Javid-Xi/IoT-Security-Alarm-System/README.md

# IoT-Security-Alarm-System

Project in [2018](https://github.com/Javid-Xi/IoT-Security-Alarm-System)  
Control Chip: STM32F103C8T6

****
For more details, please see [my blog post](https://javid.cn/lelink/)
****

## Development Environment

### 1.SOLIDWORKS 2018
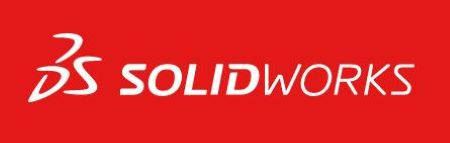
[picture p1: Photo/software/solidworks.jpg]
(https://www.solidworks.com)


### 2.Keil uVision5
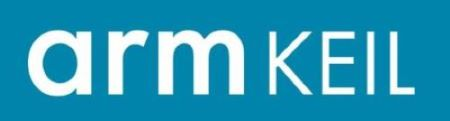
[picture p2: Photo/software/keil.jpg]
(http://www.keil.com)


### 3.Android Studio
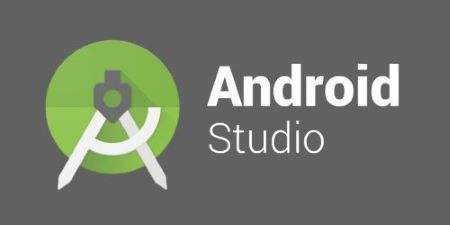
[picture p3: Photo/software/android-studio-logo.jpg]
(https://developer.android.com/studio)


### 4.STM32CubeMX
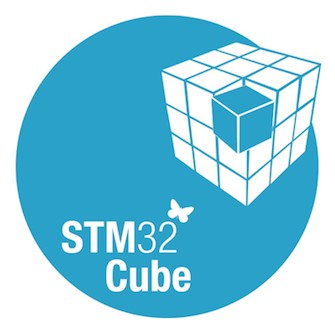
[picture p4: Photo/software/stm32cubemx.jpg]
(https://www.st.com/zh/development-tools/stm32cubemx.html)


## Cloud Platform

### 1.Gizwits(机智云)
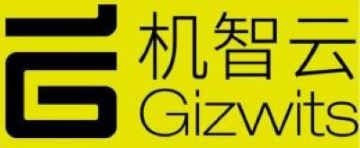
[picture p5: Photo/software/Gizwits.jpg]
(http://www.gizwits.com/)
   
(Click the picture to enter the official website of Gizwits)
