Javid-Xi/IoT-Security-Alarm-System/Model/README.md

## IoT-Security-Alarm-System

由于之前机械硬盘出现损坏，所以模型文件丢失了。现在只有当时出的渲染图了。

The model file was lost because the previous mechanical hard disk was damaged. 
Now only the Renderings is preserved.
