Javid-Xi/IoT-Security-Alarm-System/Model/baojing.jpg

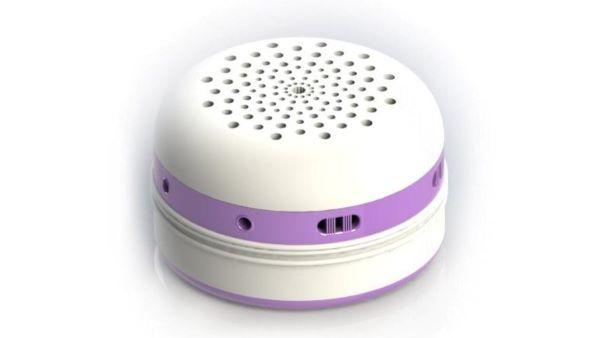
Model/baojing.jpg
