Javid-Xi/IoT-Security-Alarm-System/Model/menci.jpg

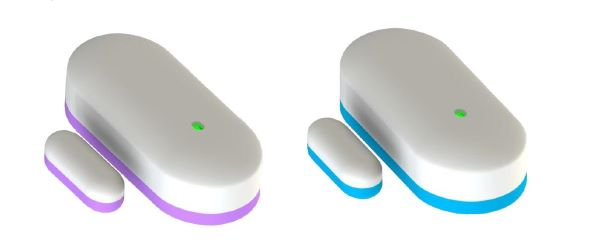
Model/menci.jpg
