Javid-Xi/IoT-Security-Alarm-System/Model/wangguan.jpg

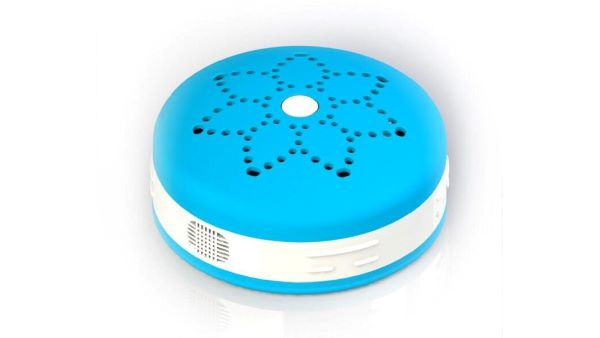
Model/wangguan.jpg
