Javid-Xi/IoT-Security-Alarm-System/Model/yanwu.jpg

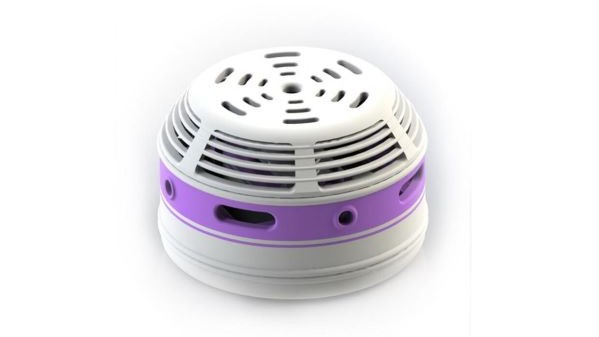
Model/yanwu.jpg
