Javid-Xi/IoT-Security-Alarm-System/Photo/Photo1.jpg

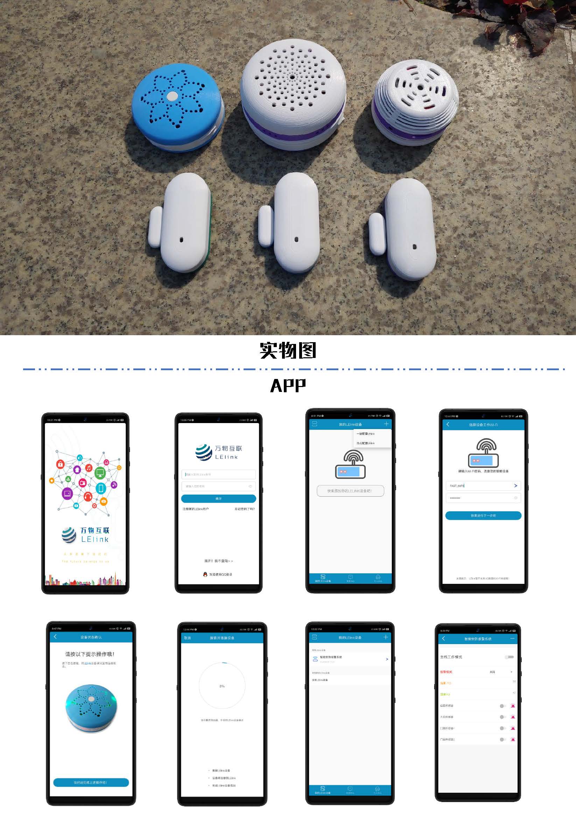
Photo/Photo1.jpg
