Javid-Xi/IoT-Security-Alarm-System/Photo/Photo2.jpg

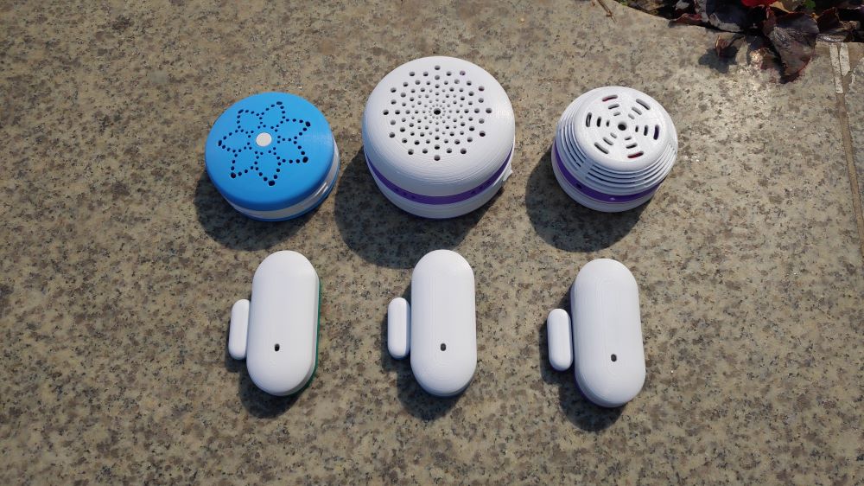
Photo/Photo2.jpg
