Javid-Xi/IoT-Security-Alarm-System/Photo/Photo4.jpg

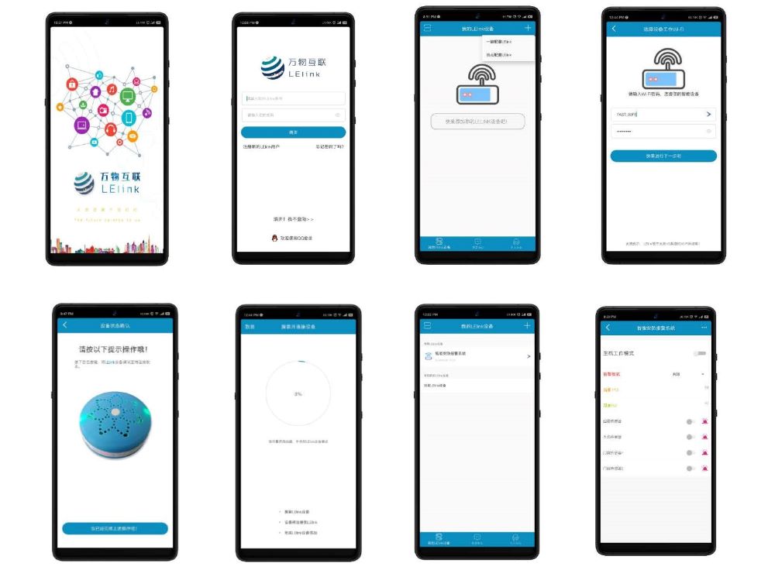
Photo/Photo4.jpg
