Javid-Xi/IoT-Security-Alarm-System/Photo/Photo-无线门磁.jpg

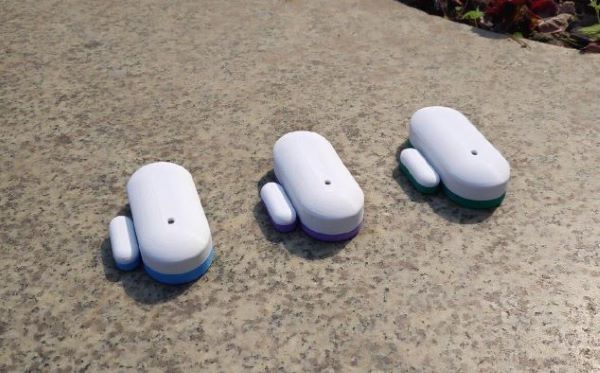
Photo/Photo-无线门磁.jpg
