Javid-Xi/IoT-Security-Alarm-System/Photo/Photo-气体监控模块.jpg

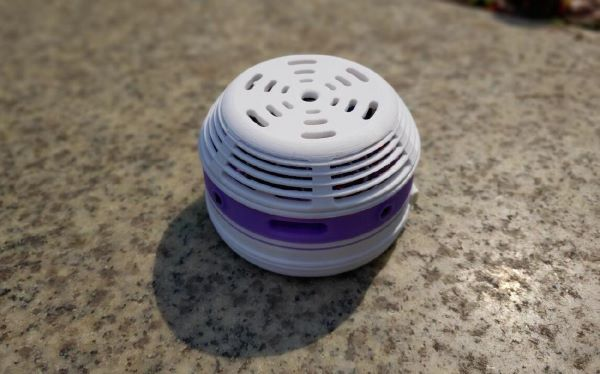
Photo/Photo-气体监控模块.jpg
