Javid-Xi/IoT-Security-Alarm-System/Photo/Photo-语音报警器.jpg

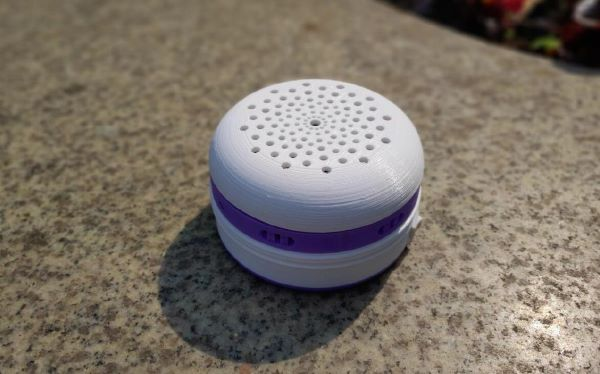
Photo/Photo-语音报警器.jpg
