Javid-Xi/IoT-Security-Alarm-System/Photo/software/freertos.jpg

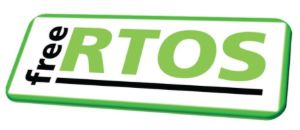
Photo/software/freertos.jpg
