Javid-Xi/IoT-Security-Alarm-System/Model/sldprt/S&F_Maincover.sldprt

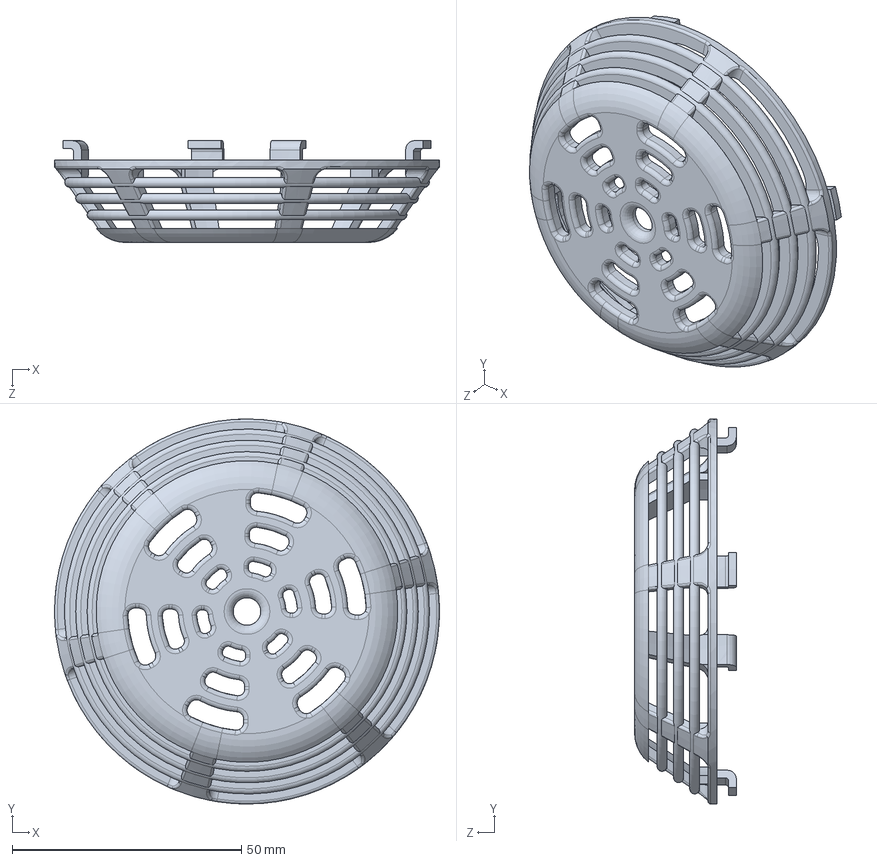
[picture p42: CAD file, 2020-02-01]
Model/sldprt/S&F_Maincover.sldprt
84.0 x 84.0 x 22.2 mm
