Javid-Xi/IoT-Security-Alarm-System/MCU_Program/MCU/Src/main.c

/**
  ******************************************************************************
  * File Name          : main.c
  * Description        : Main program body
  ******************************************************************************
  ** This notice applies to any and all portions of this file
  * that are not between comment pairs USER CODE BEGIN and
  * USER CODE END. Other portions of this file, whether
  * inserted by the user or by software development tools
  * are owned by their respective copyright owners.
  *
  * COPYRIGHT(c) 2019 STMicroelectronics
  *
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
  ******************************************************************************
  */
/* Includes ------------------------------------------------------------------*/
#include "main.h"
#include "stm32f1xx_hal.h"

/* USER CODE BEGIN Includes */
#include "hal_key.h"
#include "gizwits_product.h"
#include "common.h"
/* USER CODE END Includes */

TIM_HandleTypeDef htim2;

UART_HandleTypeDef huart1;
UART_HandleTypeDef huart2;
UART_HandleTypeDef huart3;

/* USER CODE BEGIN PV */
#define GPIO_KEY_NUM 2 ///< Defines the total number of key member
keyTypedef_t singleKey[GPIO_KEY_NUM]; ///< Defines a single key member array pointer
keysTypedef_t keys;
/* USER CODE END PV */

void SystemClock_Config(void);
static void MX_GPIO_Init(void);
static void MX_TIM2_Init(void);
static void MX_USART2_UART_Init(void);
static void MX_USART1_UART_Init(void);
static void MX_USART3_UART_Init(void);
static void MX_NVIC_Init(void);

/* USER CODE BEGIN PFP */

/* USER CODE END PFP */

/* USER CODE BEGIN 0 */
/**
* key1 short press handle
* @param none
* @return none
*/
void key1ShortPress(void)
{
    GIZWITS_LOG("KEY1 PRESS ,Production Mode\n");
    gizwitsSetMode(WIFI_PRODUCTION_TEST);
}

/**
* key1 long press handle
* @param none
* @return none
*/
void key1LongPress(void)
{
    GIZWITS_LOG("KEY1 PRESS LONG ,Wifi Reset\n");
    gizwitsSetMode(WIFI_RESET_MODE);

}

/**
* key2 short press handle
* @param none
* @return none
*/
void key2ShortPress(void)
{
    GIZWITS_LOG("KEY2 PRESS ,Soft AP mode\n");
#if !MODULE_TYPE
    gizwitsSetMode(WIFI_SOFTAP_MODE);
#endif
}

/**
* key2 long press handle
* @param none
* @return none
*/
void key2LongPress(void)
{
    //AirLink mode
    GIZWITS_LOG("KEY2 PRESS LONG ,AirLink mode\n");
#if !MODULE_TYPE
    gizwitsSetMode(WIFI_AIRLINK_MODE);
#endif
}

/**
* Key init function
* @param none
* @return none
*/
void keyInit(void)
{
    singleKey[0] = keyInitOne(NULL, KEY1_GPIO_Port, KEY1_Pin, key1ShortPress, key1LongPress);
    singleKey[1] = keyInitOne(NULL, KEY2_GPIO_Port, KEY2_Pin, key2ShortPress, key2LongPress);
    keys.singleKey = (keyTypedef_t *)&singleKey;
    keyParaInit(&keys);
}
/* USER CODE END 0 */

int main(void)
{

    /* MCU Configuration----------------------------------------------------------*/

    /* Reset of all peripherals, Initializes the Flash interface and the Systick. */
    HAL_Init();

    /* Configure the system clock */
    SystemClock_Config();

    /* Initialize all configured peripherals */
    MX_GPIO_Init();
    MX_TIM2_Init();
    MX_USART2_UART_Init();
    MX_USART1_UART_Init();
    MX_USART3_UART_Init();

    /* Initialize interrupts */
    MX_NVIC_Init();

    /* USER CODE BEGIN 2 */
    timerInit();
    uartInit();

    userInit();
    gizwitsInit();
    keyInit();
    GIZWITS_LOG("MCU Init Success \n");
    /* USER CODE END 2 */

    /* Infinite loop */
    /* USER CODE BEGIN WHILE */
    while (1)
    {
        /* USER CODE END WHILE */

        /* USER CODE BEGIN 3 */
//	HAL_UART_Transmit(&huart3,&Zigbee_data,1,10);
        userHandle();
        gizwitsHandle((dataPoint_t *)&currentDataPoint);
    }
    /* USER CODE END 3 */

}

/** System Clock Configuration
*/
void SystemClock_Config(void)
{

    RCC_OscInitTypeDef RCC_OscInitStruct;
    RCC_ClkInitTypeDef RCC_ClkInitStruct;

    /**Initializes the CPU, AHB and APB busses clocks
    */
    RCC_OscInitStruct.OscillatorType = RCC_OSCILLATORTYPE_HSE;
    RCC_OscInitStruct.HSEState = RCC_HSE_ON;
    RCC_OscInitStruct.HSEPredivValue = RCC_HSE_PREDIV_DIV1;
    RCC_OscInitStruct.HSIState = RCC_HSI_ON;
    RCC_OscInitStruct.PLL.PLLState = RCC_PLL_ON;
    RCC_OscInitStruct.PLL.PLLSource = RCC_PLLSOURCE_HSE;
    RCC_OscInitStruct.PLL.PLLMUL = RCC_PLL_MUL9;
    if (HAL_RCC_OscConfig(&RCC_OscInitStruct) != HAL_OK)
    {
        _Error_Handler(__FILE__, __LINE__);
    }

    /**Initializes the CPU, AHB and APB busses clocks
    */
    RCC_ClkInitStruct.ClockType = RCC_CLOCKTYPE_HCLK | RCC_CLOCKTYPE_SYSCLK
                                  | RCC_CLOCKTYPE_PCLK1 | RCC_CLOCKTYPE_PCLK2;
    RCC_ClkInitStruct.SYSCLKSource = RCC_SYSCLKSOURCE_PLLCLK;
    RCC_ClkInitStruct.AHBCLKDivider = RCC_SYSCLK_DIV1;
    RCC_ClkInitStruct.APB1CLKDivider = RCC_HCLK_DIV2;
    RCC_ClkInitStruct.APB2CLKDivider = RCC_HCLK_DIV1;

    if (HAL_RCC_ClockConfig(&RCC_ClkInitStruct, FLASH_LATENCY_2) != HAL_OK)
    {
        _Error_Handler(__FILE__, __LINE__);
    }

    /**Configure the Systick interrupt time
    */
    HAL_SYSTICK_Config(HAL_RCC_GetHCLKFreq() / 1000);

    /**Configure the Systick
    */
    HAL_SYSTICK_CLKSourceConfig(SYSTICK_CLKSOURCE_HCLK);

    /* SysTick_IRQn interrupt configuration */
    HAL_NVIC_SetPriority(SysTick_IRQn, 0, 0);
}

/** NVIC Configuration
*/
static void MX_NVIC_Init(void)
{
    /* TIM2_IRQn interrupt configuration */
    HAL_NVIC_SetPriority(TIM2_IRQn, 1, 0);
    HAL_NVIC_EnableIRQ(TIM2_IRQn);
    /* USART2_IRQn interrupt configuration */
    HAL_NVIC_SetPriority(USART2_IRQn, 0, 0);
    HAL_NVIC_EnableIRQ(USART2_IRQn);
    /* USART3_IRQn interrupt configuration */
    HAL_NVIC_SetPriority(USART3_IRQn, 0, 1);
    HAL_NVIC_EnableIRQ(USART3_IRQn);
}

/* TIM2 init function */
static void MX_TIM2_Init(void)
{

    TIM_ClockConfigTypeDef sClockSourceConfig;
    TIM_MasterConfigTypeDef sMasterConfig;

    htim2.Instance = TIM2;
    htim2.Init.Prescaler = 7200 - 1;
    htim2.Init.CounterMode = TIM_COUNTERMODE_UP;
    htim2.Init.Period = 10 - 1;
    htim2.Init.ClockDivision = TIM_CLOCKDIVISION_DIV1;
    htim2.Init.AutoReloadPreload = TIM_AUTORELOAD_PRELOAD_DISABLE;
    if (HAL_TIM_Base_Init(&htim2) != HAL_OK)
    {
        _Error_Handler(__FILE__, __LINE__);
    }

    sClockSourceConfig.ClockSource = TIM_CLOCKSOURCE_INTERNAL;
    if (HAL_TIM_ConfigClockSource(&htim2, &sClockSourceConfig) != HAL_OK)
    {
        _Error_Handler(__FILE__, __LINE__);
    }

    sMasterConfig.MasterOutputTrigger = TIM_TRGO_RESET;
    sMasterConfig.MasterSlaveMode = TIM_MASTERSLAVEMODE_DISABLE;
    if (HAL_TIMEx_MasterConfigSynchronization(&htim2, &sMasterConfig) != HAL_OK)
    {
        _Error_Handler(__FILE__, __LINE__);
    }

}

/* USART1 init function */
static void MX_USART1_UART_Init(void)
{

    huart1.Instance = USART1;
    huart1.Init.BaudRate = 115200;
    huart1.Init.WordLength = UART_WORDLENGTH_8B;
    huart1.Init.StopBits = UART_STOPBITS_1;
    huart1.Init.Parity = UART_PARITY_NONE;
    huart1.Init.Mode = UART_MODE_TX_RX;
    huart1.Init.HwFlowCtl = UART_HWCONTROL_NONE;
    huart1.Init.OverSampling = UART_OVERSAMPLING_16;
    if (HAL_UART_Init(&huart1) != HAL_OK)
    {
        _Error_Handler(__FILE__, __LINE__);
    }

}

/* USART2 init function */
static void MX_USART2_UART_Init(void)
{

    huart2.Instance = USART2;
    huart2.Init.BaudRate = 9600;
    huart2.Init.WordLength = UART_WORDLENGTH_8B;
    huart2.Init.StopBits = UART_STOPBITS_1;
    huart2.Init.Parity = UART_PARITY_NONE;
    huart2.Init.Mode = UART_MODE_TX_RX;
    huart2.Init.HwFlowCtl = UART_HWCONTROL_NONE;
    huart2.Init.OverSampling = UART_OVERSAMPLING_16;
    if (HAL_UART_Init(&huart2) != HAL_OK)
    {
        _Error_Handler(__FILE__, __LINE__);
    }

}

/* USART3 init function */
static void MX_USART3_UART_Init(void)
{

    huart3.Instance = USART3;
    huart3.Init.BaudRate = 115200;
    huart3.Init.WordLength = UART_WORDLENGTH_8B;
    huart3.Init.StopBits = UART_STOPBITS_1;
    huart3.Init.Parity = UART_PARITY_NONE;
    huart3.Init.Mode = UART_MODE_TX_RX;
    huart3.Init.HwFlowCtl = UART_HWCONTROL_NONE;
    huart3.Init.OverSampling = UART_OVERSAMPLING_16;
    if (HAL_UART_Init(&huart3) != HAL_OK)
    {
        _Error_Handler(__FILE__, __LINE__);
    }

}

/** Configure pins as
        * Analog
        * Input
        * Output
        * EVENT_OUT
        * EXTI
*/
static void MX_GPIO_Init(void)
{

    GPIO_InitTypeDef GPIO_InitStruct;

    /* GPIO Ports Clock Enable */
    __HAL_RCC_GPIOD_CLK_ENABLE();
    __HAL_RCC_GPIOA_CLK_ENABLE();
    __HAL_RCC_GPIOB_CLK_ENABLE();

    /*Configure GPIO pin Output Level */
    HAL_GPIO_WritePin(DHT11_DIN_GPIO_Port, DHT11_DIN_Pin, GPIO_PIN_RESET);

    /*Configure GPIO pin : KEY1_Pin */
    GPIO_InitStruct.Pin = KEY1_Pin;
    GPIO_InitStruct.Mode = GPIO_MODE_INPUT;
    GPIO_InitStruct.Pull = GPIO_NOPULL;
    HAL_GPIO_Init(KEY1_GPIO_Port, &GPIO_InitStruct);

    /*Configure GPIO pin : KEY2_Pin */
    GPIO_InitStruct.Pin = KEY2_Pin;
    GPIO_InitStruct.Mode = GPIO_MODE_INPUT;
    GPIO_InitStruct.Pull = GPIO_NOPULL;
    HAL_GPIO_Init(KEY2_GPIO_Port, &GPIO_InitStruct);

    /*Configure GPIO pin : DHT11_DIN_Pin */
    GPIO_InitStruct.Pin = DHT11_DIN_Pin;
    GPIO_InitStruct.Mode = GPIO_MODE_OUTPUT_PP;
    GPIO_InitStruct.Speed = GPIO_SPEED_FREQ_HIGH;
    HAL_GPIO_Init(DHT11_DIN_GPIO_Port, &GPIO_InitStruct);

}

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
