Javid-Xi/IoT-Security-Alarm-System/MCU_Program/MCU/STM32F103C8x.ioc

Mcu.UserName=STM32F103C8Tx
PA10.Signal=USART1_RX
PA13.Signal=SYS_JTMS-SWDIO
PA14.Signal=SYS_JTCK-SWCLK
PA2.Signal=USART2_TX
PA3.Signal=USART2_RX
PA8.GPIO_Label=KEY2
PA8.Signal=GPIO_Input
PA9.Signal=USART1_TX
PB10.Signal=USART3_TX
PB11.Signal=USART3_RX
PB2.GPIO_Label=KEY1
PB2.Signal=GPIO_Input
PB3.GPIO_Label=DHT11_DIN
PB3.Signal=GPIO_Output
PD0-OSC_IN.Signal=RCC_OSC_IN
PD1-OSC_OUT.Signal=RCC_OSC_OUT
