Javid-Xi/IoT-Security-Alarm-System/MCU_Program/MCU/Hal/hal_key.c

/**
************************************************************
* @file         hal_key.c
* @brief        按键驱动

* @author       Javid
* @date         2019-02-20
* @version      1.0
* @copyright    Javid
*
* @note
*
***********************************************************/
#include "hal_key.h"
#include <math.h>

extern keysTypedef_t keys;

uint8_t                 keyCountTime;
static uint8_t          keyTotolNum = 0;

/**
* @brief Read the GPIO state
* @param [in] keys :Key global structure pointer
* @return GPIO status 
*/
uint16_t getKey(keysTypedef_t *keyS)
{
    uint8_t i = 0; 
    uint16_t readKey = 0;              //Essential init
    
    //GPIO Cyclic scan
    for(i = 0; i < keys.keyTotolNum; i++)
    {
        if(!HAL_GPIO_ReadPin((GPIO_TypeDef*)keyS->singleKey[i].keyPort,keyS->singleKey[i].keyGpio))
        {
            G_SET_BIT(readKey, keyS->singleKey[i].keyNum);
        }
    }
    
    return readKey;
}


/**
* @brief Read the KEY value
* @param [in] keys :Key global structure pointer
* @return GPIO status
*/
uint16_t readKeyValue(keysTypedef_t *keyS)
{
    static uint8_t keyCheck = 0;
    static uint8_t keyState = 0;
    static uint16_t keyLongCheck = 0;
    static uint16_t keyPrev = 0;      //last key

    uint16_t keyPress = 0;
    uint16_t keyReturn = 0;
    
    keyCountTime ++;
    
    if(keyCountTime >= (DEBOUNCE_TIME / KEY_TIMER_MS))          //keyCountTime 1MS+1  key eliminate jitter 10MS
    {
        keyCountTime = 0;
        keyCheck = 1;
    }
    if(1 == keyCheck)
    {
        keyCheck = 0;
        keyPress = getKey(keyS);
        switch (keyState)
        {
            case 0:
                if(keyPress != 0)
                {
                    keyPrev = keyPress;
                    keyState = 1;
                }
                break;
                
            case 1:
                if(keyPress == keyPrev)
                {
                    keyState = 2;
                    keyReturn= keyPrev | KEY_DOWN;
                }
                else                //Button lift, jitter, no response button
                {
                    keyState = 0;
                }
                break;
                
            case 2:

                if(keyPress != keyPrev)
                {
                    keyState = 0;
                    keyLongCheck = 0;
                    keyReturn = keyPrev | KEY_UP;
                    return keyReturn;
                }
                if(keyPress == keyPrev)
                {
                    keyLongCheck++;
                    if(keyLongCheck >= (PRESS_LONG_TIME / DEBOUNCE_TIME))    //Long press 3S effective
                    {
                        keyLongCheck = 0;
                        keyState = 3;
                        keyReturn= keyPress | KEY_LONG;
                        return keyReturn;
                    }
                }
                break;

            case 3:
                if(keyPress != keyPrev)
                {
                    keyState = 0;
                }
                break;
        }
    }
    return  NO_KEY;
}

/**
* @brief Key call-back function

* Detects the keys state and call the corresponding callback function
* @param [in] keys :Key global structure pointer
* @return none
*/
void keyHandle(keysTypedef_t *keyS)
{
    uint8_t i = 0;
    uint16_t key_value = 0;

    key_value = readKeyValue(keyS);

    if(!key_value) return;
    
    //Check short press button
    if(key_value & KEY_UP)
    {
        //Valid key is detected
        for(i = 0; i < keyS->keyTotolNum; i++)
        {
            if(G_IS_BIT_SET(key_value, keyS->singleKey[i].keyNum)) 
            {
                //key callback function of short press
                if(keyS->singleKey[i].shortPress) 
                {
                    keyS->singleKey[i].shortPress(); 

                }
            }
        }
    }

    //Check short long button
    if(key_value & KEY_LONG)
    {
        //Valid key is detected
        for(i = 0; i < keyS->keyTotolNum; i++)
        {
            if(G_IS_BIT_SET(key_value, keyS->singleKey[i].keyNum))
            {
                //key callback function of long press
                if(keyS->singleKey[i].longPress) 
                {
                    keyS->singleKey[i].longPress(); 

                }
            }
        }
    }
} 

/**
* @brief key init function

* 
* @param [in] keyRccPeriph APB2_peripheral
* @param [in] keyPort Peripheral_declaration
* @param [in] keyGpio GPIO_pins_define 
* @param [in] short_press :Short press state callback function address
* @param [in] long_press :Long press state callback function address
* @return key structure pointer
*/
keyTypedef_t keyInitOne(uint32_t keyRccPeriph, GPIO_TypeDef * keyPort, uint32_t keyGpio, gokitKeyFunction shortPress, gokitKeyFunction longPress)
{
    static int8_t key_total = -1;

    keyTypedef_t singleKey;
    
    //Platform-defined GPIO
    singleKey.keyRccPeriph = keyRccPeriph;
    singleKey.keyPort = keyPort;
    singleKey.keyGpio = keyGpio;
    singleKey.keyNum = ++key_total;
    
    //Button trigger callback type
    singleKey.longPress = longPress;
    singleKey.shortPress = shortPress;
    
    keyTotolNum++;
    
    return singleKey;
}

/**
* @brief key parameter init function

* Keys GPIO init,start timer detect keys state
* @param [in] keys ::Key global structure pointer
* @return none
*/
void keyParaInit(keysTypedef_t *keys)
{
//     uint8_t temI = 0; 
    
    if(NULL == keys)
    {
        return ;
    }
    
    keys->keyTotolNum = keyTotolNum;
    
    //Limit on the number keys (Allowable number: 0~12)
    if(KEY_MAX_NUMBER < keys->keyTotolNum) 
    {
        keys->keyTotolNum = KEY_MAX_NUMBER; 
    }
}
