Javid-Xi/IoT-Security-Alarm-System/MCU_Program/MCU/Hal/hal_temp_hum.h

#ifndef _HAL_HEMP_HUM_H
#define _HAL_HEMP_HUM_H

#include <stdio.h>
#include <stm32f1xx_hal.h>

//Set GPIO Direction
#define	DHT11_DQ_OUT_1	 HAL_GPIO_WritePin(DHT11_DIN_GPIO_Port, DHT11_DIN_Pin, GPIO_PIN_SET)
#define	DHT11_DQ_OUT_0 	 HAL_GPIO_WritePin(DHT11_DIN_GPIO_Port, DHT11_DIN_Pin, GPIO_PIN_RESET)
#define	DHT11_DQ_IN   	 HAL_GPIO_ReadPin(DHT11_DIN_GPIO_Port, DHT11_DIN_Pin)

#define MEAN_NUM            10

typedef struct
{
    uint8_t curI;
    uint8_t thAmount; 
    uint8_t thBufs[10][2];
}thTypedef_t; 

/* Function declaration */
uint8_t dht11Init(void); //Init DHT11
uint8_t dht11Read(uint8_t *temperature, uint8_t *humidity); //Read DHT11 Value
static uint8_t dht11ReadData(uint8_t *temperature, uint8_t *humidity);
static uint8_t dht11ReadByte(void);//Read One Byte
static uint8_t dht11ReadBit(void);//Read One Bit
static uint8_t dht11Check(void);//Chack DHT11
static void dht11Rst(void);//Reset DHT11    
void dht11SensorTest(void);

#endif /*_HAL_HEMP_HUM_H*/
