Javid-Xi/IoT-Security-Alarm-System/MCU_Program/MCU_Gate_magnetism/JAVID/key.c

#include "stm32f10x.h"
#include "key.h"
#include "sys.h" 
#include "delay.h"
//////////////////////////////////////////////////////////////////////////////////	 
//按键驱动代码	   

								    
//按键初始化函数
void KEY_Init(void) //IO初始化
{ 
 	GPIO_InitTypeDef GPIO_InitStructure;
 
 	RCC_APB2PeriphClockCmd(RCC_APB2Periph_GPIOB,ENABLE);//使能GPIOB时钟

	GPIO_InitStructure.GPIO_Pin  =GPIO_Pin_1;//门磁
	GPIO_InitStructure.GPIO_Mode = GPIO_Mode_IPU; //设置成上拉输入
 	GPIO_Init(GPIOA, &GPIO_InitStructure);//初始化GPIOA

}
//按键处理函数
//返回按键值
//mode:0,不支持连续按;1,支持连续按;
//0，没有任何按键按下
//1，KEY0按下
//2，KEY1按下
//3，KEY2按下 
//4，KEY3按下 WK_UP
//注意此函数有响应优先级,KEY0>KEY1>KEY2>KEY3!!
u8 KEY_Scan(u8 mode)
{	 
	static u8 key_up=1;//按键按松开标志
	if(mode)key_up=1;  //支持连按		  
	if(key_up&&(KEY0==0||KEY1==0||KEY2==0|KEY3==0|KEY4==0|KEY5==0|KEY6==0))
	{
		delay_ms(10);//去抖动 
		key_up=0;
		     if(KEY0==0)return KEY0_PRES;
		else if(KEY1==0)return KEY1_PRES;
		else if(KEY2==0)return KEY2_PRES;
		else if(KEY3==0)return KEY3_PRES;		
		else if(KEY4==0)return KEY4_PRES;
		else if(KEY5==0)return KEY5_PRES;
		else if(KEY6==0)return KEY6_PRES;			
	}else if(KEY0==1&&KEY1==1&&KEY2==1&&KEY3==1&&KEY4==1&&KEY5==1&&KEY6==1)key_up=1; 	    
 	return 0;// 无按键按下
}
