Javid-Xi/IoT-Security-Alarm-System/(notices)

Notices in the files:
MCU_Program/MCU/Src/main.c:
(C) COPYRIGHT STMicroelectronics *****END OF FILE
